Bortle-Space/BatMax-Dock-PCB/(commit log)

2025-03-17 First push
    [Battery.kicad_sch, BatteryCC.kicad_sch, Power Delivery.kicad_sch, SingleCharger.kicad_pcb, SingleCharger.kicad_sch, bom.csv, designators.csv, positions.csv]
2025-03-17 wORKING ON REFACTOR
    [BatteryCC.kicad_sch, SingleCharger.kicad_pcb]
2025-03-18 Almost done with layout.
    [SingleCharger.kicad_pcb]
2025-03-18 Finished layout and routing.
    [SingleCharger.kicad_pcb, bom.csv, designators.csv, positions.csv]
2025-03-24 Fixed some 3D Models.
    [SingleCharger.kicad_pcb]
2025-03-24 Moved to +48V Feed. 25.2 Controlled by Pico.
    [BatteryCC.kicad_sch, Power Delivery.kicad_sch, SingleCharger.kicad_pcb, SingleCharger.kicad_sch]
2025-03-24 Updated Production Files.
    [SingleCharger.kicad_pcb]
2025-03-24 Updated Version, and Production Files.
    [SingleCharger.kicad_pcb, bom.csv, designators.csv, positions.csv]
2025-03-24 Added SCL/SDA Pins.
    [SingleCharger.kicad_pcb, SingleCharger.kicad_sch, bom.csv, designators.csv, positions.csv]
2025-03-28 Moved some things around.
    [Battery.kicad_sch]
